dayaj1222/data-glove/docs/figures/dfg-1.png

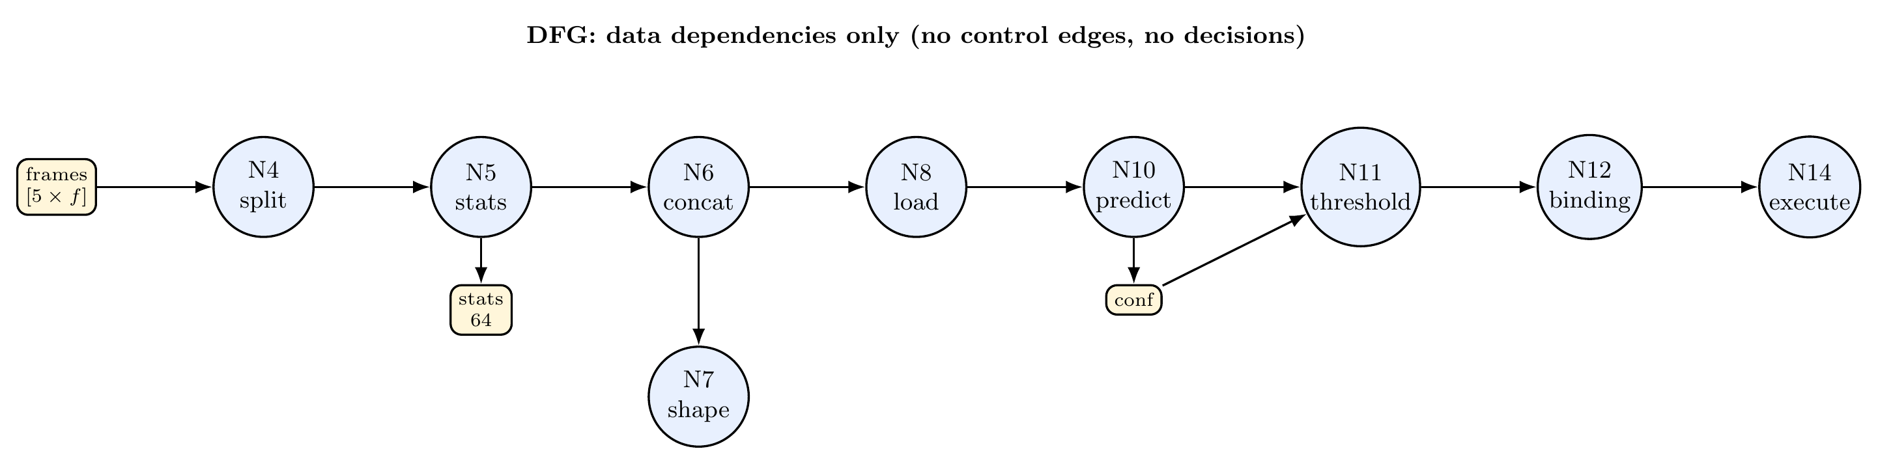
docs/figures/dfg-1.png
