dayaj1222/data-glove/docs/figures/fsm-1.png

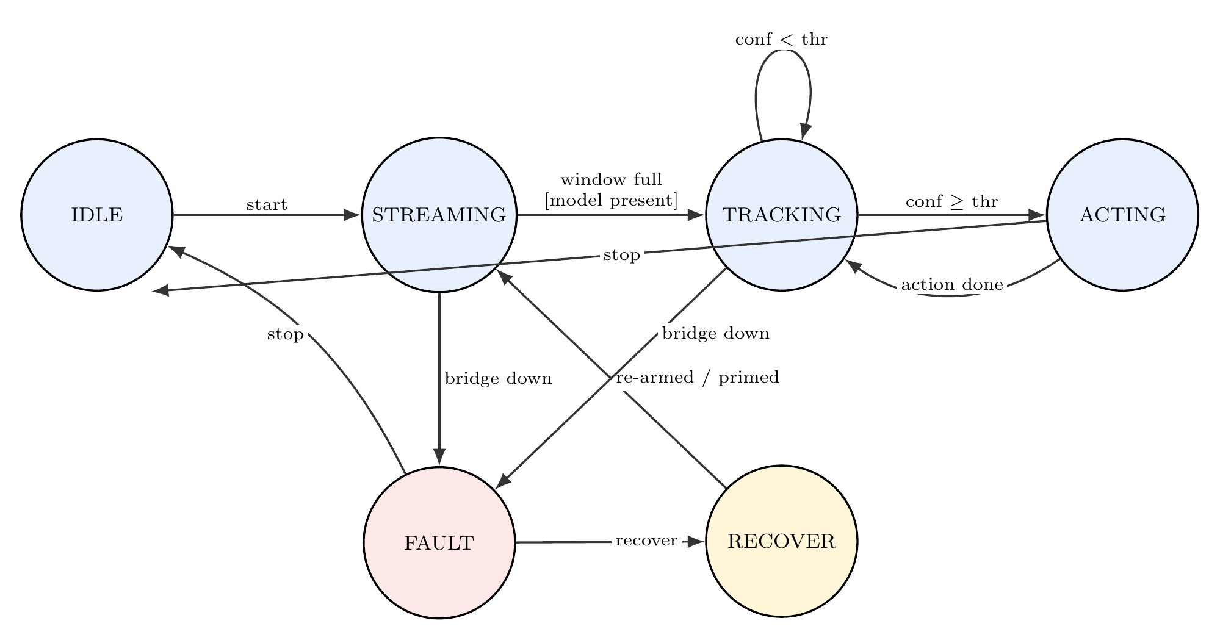
docs/figures/fsm-1.png
