dayaj1222/data-glove/docs/figures/build_photo_original.png

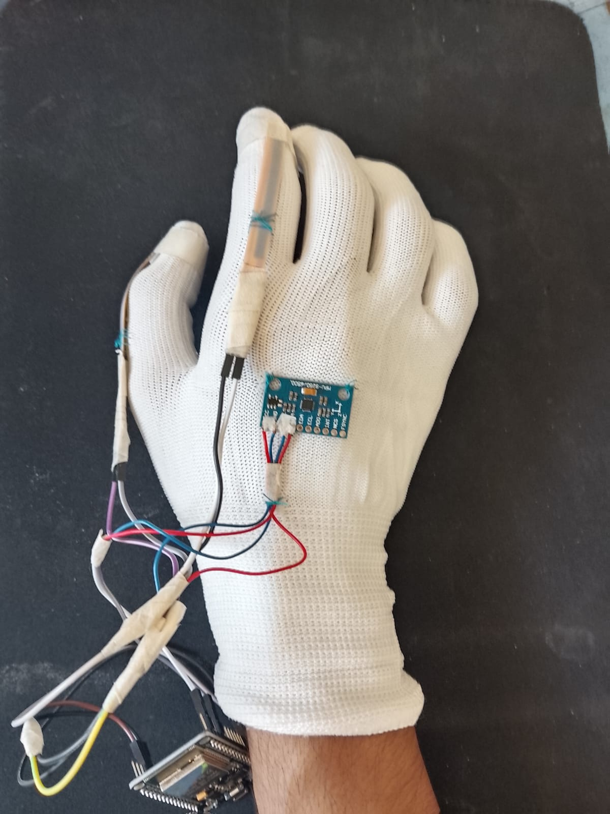
docs/figures/build_photo_original.png
