dayaj1222/data-glove/docs/figures/cdfg.pdf

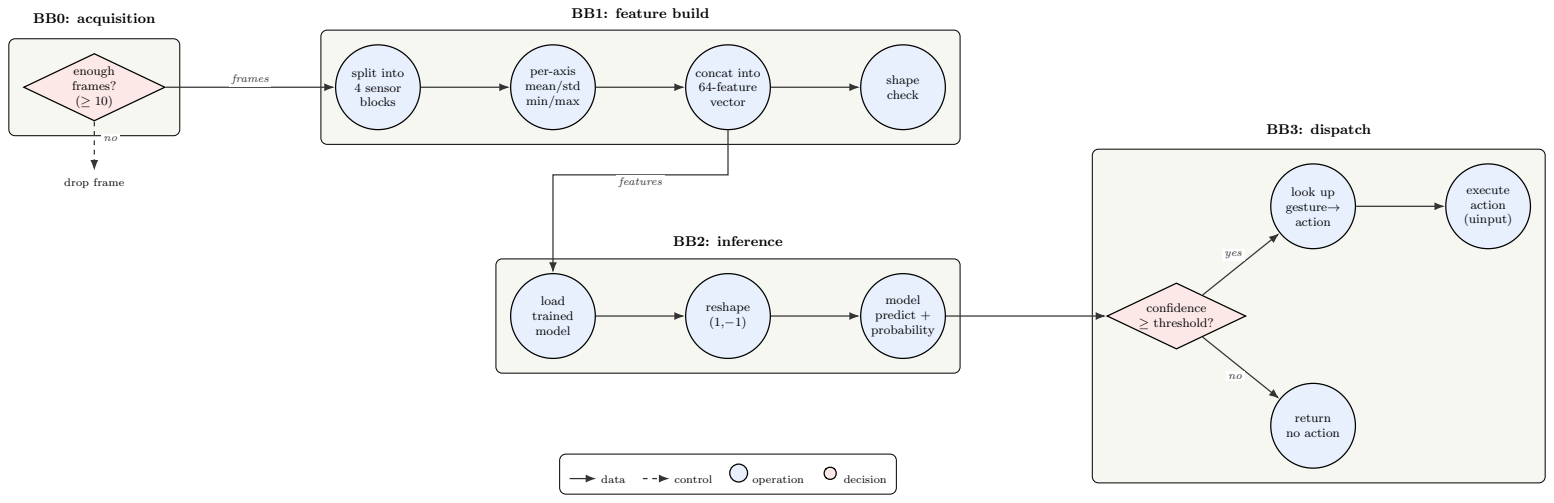
[picture p25: page 1]
enough frames? (≥ 10); split into 4 sensor blocks; per-axis mean/std min/max; concat into 64-feature vector; shape check; load trained model; reshape (1,−1); model predict + probability; confidence ≥ threshold?; look up gesture→ action; execute action (uinput); return no action; frames; features; yes; drop frame; BB0: acquisition; BB1: feature build; BB2: inference; BB3: dispatch; data; control; operation; decision
