dayaj1222/data-glove/docs/figures/dfg.pdf

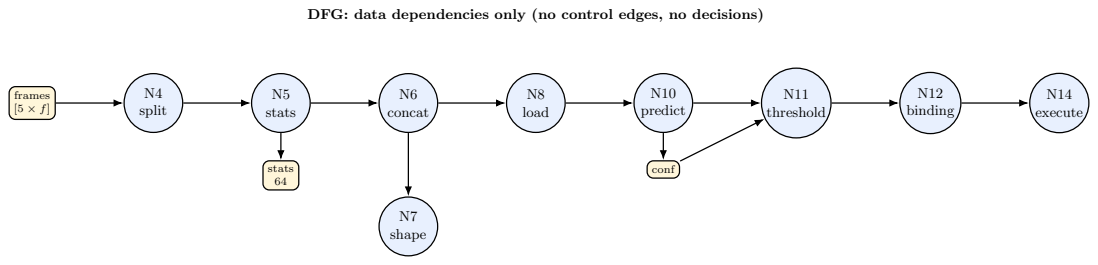
[picture p26: page 1]
frames [5 × f]; N4 split; N5 stats; N6 concat; N7 shape; N8 load; N10 predict; N11 threshold; N12 binding; N14 execute; stats 64; conf

DFG: data dependencies only (no control edges, no decisions)
