dayaj1222/data-glove/docs/figures/fsm.pdf

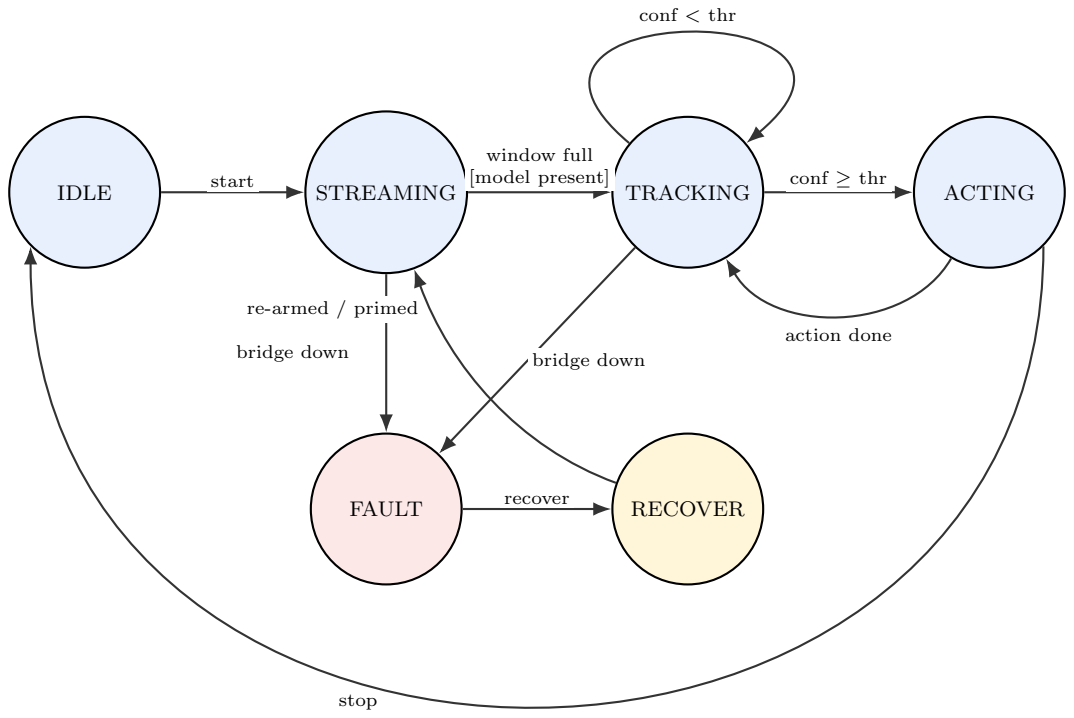
[picture p27: page 1]
IDLE; STREAMING; TRACKING; ACTING; FAULT; RECOVER; start; window full; [model present]; conf ≥ thr; action done; conf < thr; bridge down; recover; stop

re-armed / primed
