dayaj1222/data-glove/(commit log)

2026-10-12 docs: add FreeRTOS firmware task design (imuTask/flexTask/packetTask/txTask/wdtTask), tighten task set and traceability
2026-10-25 refactor: ESP32 as sole data source; extract framing + shared frontend hook
    Phone bridge removed entirely. The backend now reads the ESP32 directly over USB serial and serves flat frames to the recorder/predictor.
    Backend: device/framing.py is a pure, stateful byte-stream decoder (magic-prefixed 48-byte binary frames, headerless fallback, text lines, resync on garbage) with no I/O. serial_manager.py is reduced to port lifecycle, reader thread and bounded buffers. routers/device.py adds status/ports/logs/frame/sensors/open/close/reset/send, an SSE log stream, firmware source read-write, and arduino-cli compile+upload. routers/bridge.py is removed.
    Frontend: hooks/useEspFrame.js is one 30Hz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
    [bridge.py, device.py, flex_test_d34.ino, glove_esp32.ino, glove_full.ino, imu_mag_probe.ino, imu_test.ino]
2026-10-25 docs: correct IMU to MPU-6500 (6-axis, no magnetometer)
    The fitted part is an MPU-6500 (WHO_AM_I=0x70), not an MPU-9250. It has no magnetometer, so no register setting can produce compass data. This fixes every stale claim across report.md and report.tex:
    - MPU-9250 9-axis -> MPU-6500 6-axis in the header table, system recap, deviations paragraph, plan, and references (datasheet and register map are now the 6500 parts).
    - The 58-byte datagram is wrong. Five uint16 flex counts plus nine float32 slots is 46 bytes of payload; with the 0xAA55 magic the frame is 48 bytes. Corrected in both files.
    - The magnetometer slots are explained as always zero rather than presented as a live sensor.
    The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
2026-10-26 backend: air mouse via uinput, serial auto-reconnect, port fallback
    - aircursor: relative desktop cursor, 3 palm zones x 3 finger gestures,
    clutch, click hold, palm-pose and finger calibration, per-frame processing
    - /api/cursor router; evdev dependency
    - serial_manager: reader reconnects when the board re-enumerates, open()
    swaps a stale ttyUSB path for the one that exists
    - tests: 23 aircursor tests
    [aircursor.py, cursor.py, device.py, main.py, serial_manager.py, test_aircursor.py, test_framing.py]
2026-10-26 frontend: sniper rewrite, puzzle game, air mouse panel, finger pointer
    - lib/pointer.js: pitch/yaw of the pointing finger from accel+gyro
    - SniperUI: new aiming and graphics; PuzzleUI: jigsaw with flex grab
    - AirMouseUI: gesture grid, calibration setup, live tiles
    - DeviceMonitor: show the 2 real flex channels, correct ADC scale
2026-10-26 firmware + notes: 2 flex sensors on D34/D35, session findings
    [glove_full.ino]
2026-10-27 backend: frames-since endpoint, serve built UI, health check, clean reset on open
    - GET /api/device/frames?since=N returns every frame since a counter (frames arrive in bursts)
    - main.py serves frontend/build and exposes /api/health
    - SerialManager pulses EN with IO0 released on open so the firmware always boots into run mode
    - AirCursor takes calibration_path so tests never read the user's saved palm poses
    [aircursor.py, device.py, main.py, serial_manager.py, test_aircursor.py, test_device_frames.py]
2026-10-27 frontend + demo: 3D hand, block stacker game, one-command run-demo.sh
    - Hand 3D view (three.js, Mahony orientation filter, auto-zero heading)
    - Blocks 3D game with cannon-es rigid bodies and a solid kinematic claw
    - useGlove hook shared by the 3D views
    - run-demo.sh: clears stale servers, builds the UI, starts and supervises the backend, connects the glove, opens the browser
    - README with the demo and air-mouse reference
2026-10-27 docs: final report, Review 2 and presentation guide, filled; figures and their generators
    Final report describes the system as built (USB serial, 2 flex + MPU-6500, 9-gesture air mouse)
    with measurements from docs/measurements. Review 2 is the submitted design-stage document with the
    IMU corrected to MPU-6500. Open items (demo link, signatures, partner evidence) are listed in AGENTS.md.
    [make_a.py, make_b.py, make_fsm.py, make_modules.py, make_photo.py]
